juanscastano-maker/Carro_trepador/docs/guias/Guia_de_estudio_software_Carro_trepador.docx

Carro Trepador

Guía de estudio del software

Cómo está hecho el software del robot, cómo estudiarlo para entenderlo y cómo probarlo parte por parte

Nodos de ROS 2 (PC) · Firmware de la ESP32-S3 · Pruebas

Contenido

Si el índice aparece vacío, en Word: clic derecho sobre él → Actualizar campos.

# 1. Para qué sirve esta guía

El software del Carro Trepador tiene dos partes que trabajan juntas: los nodos de ROS 2, que corren en el PC y toman las decisiones, y el firmware, que corre en la ESP32-S3 y mueve el hardware. En total son unas 2 900 líneas de código repartidas en una veintena de archivos.

Esta guía explica qué hace cada archivo, propone un orden para estudiarlo (de lo más simple a lo más complejo), deja preguntas guía con sus respuestas al final para comprobar que lo entendiste, y describe cómo probar cada parte, desde las pruebas automáticas hasta el robot en la pared.

El documento de referencia es docs/arquitectura/Arquitectura_Carro_trepador_v5.docx junto con el grafo grafo nodos microproyecto.drawio.png: todo el código es ese grafo convertido en programa.

Estado actual: todo el software compila y pasa sus pruebas en el PC, incluido el sistema completo con el firmware simulado. El firmware no se ha probado todavía en la placa real: esa prueba se hace siguiendo la sección 5.

# 2. El sistema en una página

Ninguna orden llega directo a los motores: todo pasa antes por el supervisor. La única excepción es la parada de emergencia, que va de la GUI directo al firmware para que funcione aunque el supervisor falle.

ÓRDENES

GUI ─/cmd_vel─────────────→ supervisor ─/cmd_vel_safe────→ cinemática

cinemática ─/cmd_motors───→ firmware → motores N20

GUI ─/suction_gui_request─→ supervisor ─/suction_override→ succión

succión ─/cmd_suction/*───→ firmware → turbinas

GUI ─/e_stop──────────────→ firmware y supervisor (parada del operador)

supervisor ─/heartbeat────→ firmware (watchdog)

SENSORES E INFORMACIÓN

firmware ─/imu/*/data─────→ supervisor, succión y estimador

estimador ─/joint_states, /tf→ robot_state_publisher → RViz2

firmware ─/battery/state──→ supervisor y GUI

supervisor ─/gui/notifications→ GUI

firmware (núcleo 0) ══video HTTP MJPEG══→ GUI (fuera de ROS 2)

## 2.1 Los nodos y lo que hace cada uno

Nodo | Qué hace
custom_gui_node | Interfaz del operador: movimiento, petición de succión, parada y liberación, modo prueba, estado del robot, batería tipo celular, notificaciones y video.
state_machine_node (supervisor) | Decide si el robot está en SUELO, TRANSICIÓN o PARED; limita velocidad y succión; envía el heartbeat al firmware y notifica todo a la GUI. No activa la parada: eso lo decide solo el operador.
kinematics_node | Convierte la velocidad del robot (m/s y rad/s) en la potencia de los motores izquierdo y derecho (−1 a 1).
suction_control_node | Calcula la succión de cada turbina según la inclinación de su módulo; el supervisor solo puede subirla.
joint_state_estimator_node | Calcula el ángulo de la articulación central con las dos IMU y la inclinación del robot para RViz2.
robot_state_publisher | Nodo estándar de ROS 2: con el URDF y /joint_states calcula la posición de cada pieza.
micro_ros_esp32_node (firmware) | Lee IMU y batería, mueve motores y turbinas con rampas, vigila el heartbeat y la parada, y transmite el video.

## 2.2 El video

Tal como dice la arquitectura, el video no pasa por ROS 2: sale directo del núcleo 0 de la ESP32 por HTTP. Al arrancar, el firmware muestra su IP por el monitor serie y ofrece tres direcciones:

- http://<ip-robot>/: página con el video, para abrirla en cualquier navegador.
- http://<ip-robot>:81/stream: video MJPEG; es la dirección que se le pasa a la GUI con url_video.
- http://<ip-robot>/foto: una foto JPEG suelta.

Límite: el servidor de la ESP32 atiende un solo cliente de video a la vez. Si la GUI está mostrando el video, otro dispositivo no lo verá al mismo tiempo. Para verlo en varios equipos haría falta un nodo en el PC que lo lea una vez y lo reparta (sección 12.4 de la arquitectura); hoy no está en el grafo y no está implementado.

## 2.3 Reglas de seguridad del firmware

Modo | Cuándo | Qué hace
ESPERANDO | Desde que se enciende hasta el primer heartbeat | Nada se mueve: motores parados y turbinas apagadas. LED azul (o naranja si no hay agente).
NORMAL | Llega el heartbeat y no hay parada | Aplica las órdenes de motores y turbinas con rampas. LED verde.
PARADA | El operador activó la parada | Motores frenados al instante. Turbinas al máximo si el robot no está en el suelo; apagadas si está en el suelo. LED rojo.
MODO SEGURO | Más de 500 ms sin heartbeat (supervisor caído o Wi-Fi perdido) | Igual que PARADA. Vuelve solo a NORMAL cuando regresa el heartbeat. LED rojo.

# 3. Qué hay en el repositorio

## 3.1 Las carpetas

Carpeta o archivo | Qué contiene
README.md | Descripción general del proyecto, requisitos, instalación y cómo correr todo.
docs/Anteproyecto, Lista de materiales | El planteamiento del proyecto y los componentes a comprar.
docs/arquitectura/ | Documento de arquitectura y los grafos de nodos del robot real y de la simulación.
docs/electronica/ | Documento de conexiones, tabla con los 50 cables (CSV), diagrama de alimentación y de señales (draw.io y PNG).
docs/guias/ | Esta guía de estudio.
docs/simulacion/ | Documento de la simulación en Gazebo.
docs/cinematica/CAD/ | Ensamble de SolidWorks y su exportación a URDF. No se sube a GitHub por su tamaño.
docs/*.png | Pinouts de la placa ESP32-S3 y de los módulos DRV8833, INA226 y MPU6050.
ros2_ws/src/carro_trepador_interfaces | Mensaje propio Notificacion.msg.
ros2_ws/src/carro_trepador_control | Supervisor, cinemática, succión y estimador de postura, con sus pruebas.
ros2_ws/src/carro_trepador_teleop | Interfaz del operador.
ros2_ws/src/carro_trepador_bringup | Launch, parámetros, configuración de RViz2 y firmware simulado.
ros2_ws/src/carro_trepador_description | Modelo URDF con las mallas de SolidWorks y display.launch.py (RViz2 con deslizadores para mover las articulaciones).
ros2_ws/src/carro_trepador_simulation | Simulación en Gazebo (launch, mundo y sim_bridge_node). Sin probar a fondo: está en pausa mientras se trabaja con el robot real.
firmware/ | Proyecto de PlatformIO de la ESP32-S3: firmware del robot, drivers y programas de prueba.
scripts/ | adaptar_urdf_solidworks.py (convierte la exportación de SolidWorks), diagrama_alimentacion.py (dibuja el diagrama de alimentación) y generar_guia_estudio.js (genera esta guía).
matlab/, hardware/ | Reservadas para modelos matemáticos y archivos de fabricación; por ahora vacías.

## 3.2 Software del PC (ros2_ws/src)

Archivo | Líneas | Qué hace
carro_trepador_control/kinematics_node.py | 65 | Cinemática diferencial: /cmd_vel_safe → /cmd_motors.
carro_trepador_control/control/imu.py | 56 | Inclinación, cabeceo y alabeo a partir de un mensaje de IMU. Lo usan los demás nodos.
carro_trepador_control/suction_control_node.py | 125 | Succión automática por inclinación, con rampa y con el override del supervisor.
carro_trepador_control/joint_state_estimator_node.py | 123 | Ángulo de la articulación central y /tf para RViz2.
carro_trepador_control/state_machine_node.py | 323 | Supervisor: estados, límites, modo prueba, heartbeat y notificaciones.
carro_trepador_teleop/custom_gui_node.py | 509 | Interfaz PyQt5 del operador.
carro_trepador_interfaces/msg/Notificacion.msg | — | Mensaje propio de las notificaciones (INFO, AVISO, ALERTA).
carro_trepador_bringup/launch/bringup.launch.py | 78 | Arranca todo el sistema con un solo comando.
carro_trepador_bringup/config/parametros.yaml | — | Parámetros de todos los nodos en un solo lugar.
carro_trepador_bringup/rviz/robot.rviz | — | Configuración de RViz2 con el marco fijo odom.
carro_trepador_bringup/firmware_simulado.py | 182 | Herramienta de prueba: hace de ESP32 en el PC. No es parte de la arquitectura.
carro_trepador_control/test/*.py | ~250 | Pruebas unitarias y de integración (sección 4.5).

## 3.3 Firmware (firmware/)

Archivo | Líneas | Qué hace
platformio.ini | — | Configuración de PlatformIO: un entorno para el robot y uno por cada prueba de hardware.
include/pines.h | 82 | Mapa de pines y canales PWM, con el motivo de cada elección.
include/credenciales_wifi.ejemplo.h | — | Plantilla de la red Wi-Fi y la IP del PC (agente).
lib/Rampa/Rampa.h | 69 | Limitador de pendiente: arranques y frenadas graduales.
lib/Mpu6050/ | 148 | Driver de la IMU con interrupción de dato listo.
lib/Ina226/ | 143 | Driver del medidor de voltaje y corriente.
lib/Drv8833/ | 146 | Driver del puente H de los motores, con rampa.
lib/EscPwm/ | 93 | Señal de 50 Hz para los ESC de las turbinas, con rampa.
lib/FiltroOrientacion/FiltroOrientacion.h | 81 | Filtro de Mahony: orientación a partir de giroscopio y acelerómetro.
src/main.cpp | 511 | Firmware del robot (micro_ros_esp32_node): micro-ROS, sensores, actuadores y seguridad.
src/robot/video.cpp | 118 | Cámara OV2640 y servidor de video en el núcleo 0.
src/pruebas/*.cpp | — | Un programa por componente: cámara, IMU, motores, INA226 y ESC.

# 4. Ruta de estudio

La idea es avanzar de lo simple a lo complejo y, en cada paso, ejecutar el código además de leerlo. Leer sin ejecutar se olvida rápido; ver un número cambiar en la terminal se queda.

## 4.1 Etapa 0: el panorama (1 hora)

1. Abre el grafo grafo nodos microproyecto.drawio.png y el documento de arquitectura.
2. Repasa la sección 2 de esta guía y ubica cada nodo en el grafo.
3. Durante todo el estudio, cada vez que leas un nodo, búscalo en el grafo: qué recibe y qué publica.

## 4.2 Etapa 1: lo básico de ROS 2 (2 o 3 días)

Haz los tutoriales oficiales de ROS 2 Humble en docs.ros.org/en/humble/Tutorials.html. Con ellos se entiende la mayor parte del código del PC:

- Beginner: CLI tools: nodos, tópicos, servicios, parámetros, rqt y launch.
- Beginner: Client libraries: «Writing a simple publisher and subscriber (Python)», «Writing a simple service and client (Python)» y «Using parameters in a class (Python)».
- Intermediate: tf2: solo «Introducing tf2», para entender /tf y RViz2.

Conceptos que debes dominar al terminar: nodo, tópico, mensaje, servicio, parámetro, QoS, launch y TF (ver el glosario de la sección 8).

## 4.3 Etapa 2: los nodos del PC, en este orden

Archivo | Qué aprendes | Pregunta guía
1. kinematics_node.py | La estructura de un nodo: suscribirse, calcular y publicar. | P1. ¿Qué publica si pido 0.5 m/s y 2 rad/s a la vez?
2. control/imu.py | Cuaterniones y ángulos de inclinación. | P2. ¿Por qué hay dos formas de calcular cada ángulo?
3. suction_control_node.py | Timers, rampas y combinar dos fuentes con max(). | P3. ¿Por qué la succión baja más lento de lo que sube?
4. joint_state_estimator_node.py | /joint_states, /tf y robot_state_publisher. | P4. ¿Por qué el robot no avanza en RViz2 aunque el real sí?
5. state_machine_node.py | Máquina de estados, QoS, servicios e histéresis. | P5. ¿Para qué sirven los ±5° alrededor de los umbrales?
6. custom_gui_node.py | PyQt5 y cómo convive con ROS 2 (un timer que llama spin_once). | P6. ¿Por qué /cmd_vel se publica aunque sea cero?
7. bringup.launch.py y parametros.yaml | Launch con argumentos y condiciones. | P7. ¿Qué cambia con simulado:=true?

Para cada nodo, arranca el sistema simulado y obsérvalo desde afuera:

ros2 launch carro_trepador_bringup bringup.launch.py simulado:=true

rqt_graph # el grafo real: compáralo con tu drawio

ros2 node info /suction_control_node # qué publica y qué recibe

ros2 topic echo /cmd_suction/front # los valores en vivo

ros2 param set /firmware_simulado inclinacion_delantera 45.0

## 4.4 Etapa 3: el firmware, en este orden

1. include/pines.h: qué hay conectado a cada pin y por qué. Ya lo conoces por el diagrama de conexiones.
2. lib/Rampa/Rampa.h: la idea que más se repite en el firmware. Es corto y no depende de nada.
3. Los programas de src/pruebas/: cada uno usa un solo driver. Súbelos a la placa mientras los lees (sección 5.3).
4. src/main.cpp, por funciones:
  - setup(): el orden de arranque. P8. ¿Por qué los ESC se inician primero?
  - loop(): lo que se hace en cada vuelta, sin esperas.
  - atenderAgente(): la conexión con el PC y la reconexión automática (máquina de estados).
  - aplicarActuadores(): la seguridad. Es la función más importante del firmware. P9. ¿Qué pasa con las turbinas si se corta el Wi-Fi con el robot en la pared?
5. lib/FiltroOrientacion/FiltroOrientacion.h: al final. Busca primero un video de «complementary filter IMU» y luego «Mahony filter». No hace falta entender cada fórmula, sino la idea: el giroscopio es rápido pero se desvía; el acelerómetro sabe dónde está abajo y corrige ese desvío.
6. src/robot/video.cpp: cómo se arma un video MJPEG (una imagen JPEG tras otra, separadas por un límite).

Para micro-ROS, el tutorial oficial está en micro.ros.org (Tutorials → micro-ROS for Arduino / PlatformIO): ahí aparece el mismo patrón de crear entidades y vigilar al agente que usa main.cpp.

## 4.5 Etapa 4: las pruebas (aprende rompiendo)

Una prueba unitaria es un programa que llama a una función con datos conocidos y revisa que el resultado sea el esperado. Por ejemplo, test_succion.py comprueba que con 45° de inclinación la succión sea 35 %. Si mañana cambias el código y rompes algo, la prueba falla y te avisa antes de que lo descubras con el robot en la pared.

Una prueba de integración pone a funcionar varias piezas juntas. test_supervisor.py corre el supervisor de verdad con ROS 2, le envía IMU y órdenes falsas, y revisa lo que publica.

Archivo | Qué prueba
test_cinematica.py | Quieto, avanzar y retroceder, girar en el sitio y que ninguna rueda pase de 100 % sin cambiar la curva.
test_succion.py | Succión en el suelo, en la pared y en medio; que nunca baje al inclinarse más.
test_imu.py | Inclinación, cabeceo y alabeo con acelerómetro y con cuaternión; que no invente un ángulo sin datos.
test_estimador.py | Conversión de ángulos a cuaternión.
test_supervisor.py | Integración: límite de velocidad, parada y liberación, succión mínima en la pared y GUI caída.
test_flake8.py, test_pep257.py | Formato del código según las reglas de ROS 2 (líneas de máximo 99 caracteres, documentación).

### Ejercicios

1. Corre la prueba más simple y lee su salida: python3 -m pytest src/carro_trepador_control/test/test_cinematica.py -v.
2. Rompe el código a propósito: en kinematics_node.py cambia / 2.0 por / 3.0 y vuelve a correr la prueba. Mira cuál falla y por qué. Después deshaz el cambio.
3. Escribe tu propia prueba en test_succion.py: que a 35° la succión sea 17.5 %.
4. Cambia succion_pared en parametros.yaml, recompila (colcon build) y observa el cambio con el sistema simulado.

# 5. Cómo probar parte por parte

Las pruebas van de lo más seguro a lo más arriesgado. No pases al siguiente nivel hasta que el anterior funcione.

## 5.1 Nivel 1: pruebas automáticas (sin robot, segundos)

cd ~/Carro_trepador/ros2_ws

colcon build && source install/setup.bash

colcon test && colcon test-result --verbose

Resultado esperado: 38 tests, 0 errors, 0 failures, 3 skipped. Los 3 omitidos son las revisiones de licencia, que vienen desactivadas en ROS 2.

## 5.2 Nivel 2: el sistema completo sin robot (minutos)

ros2 launch carro_trepador_bringup bringup.launch.py simulado:=true

# en otra terminal, simular que el robot sube a la pared:

ros2 param set /firmware_simulado inclinacion_delantera 90.0

ros2 param set /firmware_simulado inclinacion_trasera 90.0

- La GUI muestra «Robot conectado» y la batería.
- Con W el robot avanza: la orden aparece en la GUI y en ros2 topic echo /cmd_motors.
- El estado cambia a TRANSICIÓN y luego a PARED; en RViz2 el robot se dobla y luego queda vertical.
- Espacio activa la parada; «Liberar parada» solo funciona con los controles sueltos.
- Al cerrar la GUI aparece la notificación de órdenes detenidas (en el log del supervisor).
- imu_delantera_activa:=false genera el aviso de IMU sin datos.

## 5.3 Nivel 3: el hardware, un componente a la vez

PlatformIO: el comando pio instalado en el sistema es una versión antigua (4.3.4) y falla con este proyecto. Usa el botón de PlatformIO en VS Code o la ruta completa ~/.platformio/penv/bin/pio.

Puerto USB: se programa por el USB-C marcado COM (chip CH343), que en Linux aparece como /dev/ttyACM0. Mientras el USB esté conectado, desconectar el rojo del BEC trasero: la ESP32 nunca debe recibir 5 V de dos fuentes a la vez.

# | Entorno (en firmware/) | Qué revisar

1 | prueba_imus | Las dos IMU responden (0x68 y 0x69), INT cerca de 100 Hz, az ≈ 9.8 m/s² con el robot plano.
2 | prueba_potencia | El voltaje coincide con el multímetro. Ajustar R_SHUNT y CORRIENTE_MAX al shunt instalado.
3 | prueba_motores | Con las ruedas en el aire: on y luego w; los dos lados giran hacia adelante.
4 | prueba_esc | Sin hélices o con el robot sujeto: armado con pitidos y la turbina sube suave.
5 | prueba_camara | El video se ve en el navegador.

Cada prueba se sube y se abre el monitor serie así (cambiando el nombre del entorno):

~/.platformio/penv/bin/pio run -e prueba_imus -t upload

~/.platformio/penv/bin/pio device monitor

## 5.4 Nivel 4: el firmware real conectado a ROS 2

1. Copia firmware/include/credenciales_wifi.ejemplo.h como credenciales_wifi.h y pon tu red Wi-Fi y la IP del PC (se ve con hostname -I y se escribe con comas: 192, 168, 1, 100). La red debe ser de 2.4 GHz y la misma para el PC y la ESP32; las redes de la universidad con usuario o página de inicio no sirven (usar el punto de acceso del celular).
2. Sube el firmware con las turbinas sin hélices y las ruedas en el aire:

~/.platformio/penv/bin/pio run -e esp32s3_cam -t upload

~/.platformio/penv/bin/pio device monitor

El monitor debe mostrar las IMU, el INA226 y la cámara como «ok», y luego la IP del robot y la dirección del video.

3. Carga el agente de micro-ROS (ya compilado en ~/microros_ws) y lanza todo:

source ~/microros_ws/install/setup.bash

ros2 launch carro_trepador_bringup bringup.launch.py \

url_video:=http://<ip-robot>:81/stream

Ojo con los < >: en los comandos, lo que va entre < y > se reemplaza completo, sin los signos. Por ejemplo url_video:=http://192.168.53.20:81/stream. Si se escriben los signos, la terminal los interpreta como «leer de un archivo» y responde «No existe el archivo o el directorio».

El LED de la placa debe pasar de naranja (sin agente) a verde (normal).

4. Prueba la seguridad antes de poner hélices:
- Espacio: las ruedas paran al instante y el LED se pone rojo.
- Ctrl+C en el launch: en menos de 0.5 s el robot entra en modo seguro (LED rojo, ruedas paradas).
- Con el robot inclinado a mano, las turbinas suben; en el suelo se apagan.
- Al volver a lanzar, el firmware se reconecta solo.
5. Cuando todo lo anterior funcione: hélices, primero con TURBINA_TOPE bajo en main.cpp (por ejemplo 0.4f), luego en el suelo y al final en la pared.

# 6. Respuestas a las preguntas guía

Intenta responder cada pregunta antes de leer la respuesta.

P1. ¿Qué publica kinematics_node si pido 0.5 m/s y 2 rad/s?

Sin límite, la rueda izquierda iría a (0.5 − 2·0.0829)/0.39 = 0.86 y la derecha a (0.5 + 2·0.0829)/0.39 = 1.71 (0.39 m/s es la velocidad máxima de rueda de los N20 a 5 V). Como la derecha pasa de 1, las dos se dividen por 1.71: quedan 0.50 y 1.00. Se conserva la proporción entre ruedas, así que el robot sigue la misma curva, solo que más despacio. (En el sistema completo, el supervisor ya habría limitado antes la velocidad a 0.25 m/s.)

P2. ¿Por qué hay dos formas de calcular cada ángulo?

Si el mensaje trae orientación (el firmware la calcula con el filtro de Mahony), se usa esa, porque es más estable. Si no la trae (orientation_covariance[0] = −1, la convención de ROS), se calcula solo con el acelerómetro, que vale mientras el robot no acelere fuerte.

P3. ¿Por qué la succión baja más lento de lo que sube?

Subir rápido sirve para agarrarse cuanto antes al empezar a trepar. Bajar despacio evita que el robot se suelte de golpe por un cambio brusco y reduce los picos de corriente en los ESC.

P4. ¿Por qué el robot no avanza en RViz2?

Para saber cuánto avanzó haría falta odometría (encoders en las ruedas) y para saber su rumbo un magnetómetro. El robot no tiene ninguno de los dos, así que RViz2 lo dibuja siempre en el origen. Lo que sí se ve igual que en la realidad es la inclinación y cómo se dobla la articulación.

P5. ¿Para qué sirven los ±5° alrededor de los umbrales?

Es histéresis. Si el robot está justo en 25°, la vibración haría saltar el estado entre SUELO y TRANSICIÓN muchas veces por segundo, con una notificación en cada salto. Con ±5°, para pasar a TRANSICIÓN hay que superar 30° y para volver a SUELO hay que bajar de 20°.

P6. ¿Por qué /cmd_vel se publica aunque sea cero?

Así el supervisor sabe que la GUI sigue viva. Si deja de recibir /cmd_vel por 0.5 s (la GUI se cerró o se colgó), pone la velocidad en cero y avisa. Si la GUI solo publicara al moverse, el supervisor no podría distinguir «quieto» de «GUI caída».

P7. ¿Qué cambia con simulado:=true?

El launch no arranca el agente de micro-ROS (no hay ESP32) y en su lugar arranca firmware_simulado, que publica y recibe los mismos tópicos que el firmware real. Los demás nodos no se enteran de la diferencia.

P8. ¿Por qué los ESC se inician primero en setup()?

Un ESC solo se arma si al recibir batería ve la señal de 0 % (pulso de 1000 µs). Si la ESP32 tardara en empezar a mandar la señal, el ESC podría quedar sin armar o, peor, leer un pulso cualquiera. Por eso es lo primero que se configura.

P9. ¿Qué pasa con las turbinas si se corta el Wi-Fi con el robot en la pared?

Deja de llegar el heartbeat; a los 500 ms el firmware entra en MODO SEGURO: frena los motores y, como las IMU dicen que no está en el suelo, sube las turbinas al máximo para que quede pegado. Cuando vuelve la conexión y el heartbeat, regresa solo a NORMAL.

# 7. Comandos útiles

Comando | Para qué sirve
colcon build && source install/setup.bash | Compilar el workspace y cargarlo en la terminal.
ros2 launch carro_trepador_bringup bringup.launch.py simulado:=true | Todo el sistema sin robot.
ros2 node list | Qué nodos están corriendo.
ros2 node info /<nodo> | Qué publica, recibe y ofrece un nodo.
ros2 topic list / ros2 topic echo <tópico> | Ver los tópicos y sus mensajes en vivo.
ros2 topic hz <tópico> | Frecuencia real de un tópico (las IMU deben estar cerca de 50 a 100 Hz).
ros2 param list / ros2 param set /<nodo> <param> <valor> | Ver y cambiar parámetros en vivo.
ros2 service call /set_test_mode std_srvs/srv/SetBool "{data: true}" | Activar el modo prueba sin la GUI.
rqt_graph | Dibujo del grafo real de nodos y tópicos.
colcon test && colcon test-result --verbose | Correr todas las pruebas.
python3 -m pytest <archivo> -v | Correr un archivo de pruebas con detalle.
~/.platformio/penv/bin/pio run -e <entorno> -t upload | Compilar y subir el firmware o una prueba.
~/.platformio/penv/bin/pio device monitor | Ver el monitor serie de la ESP32.

# 8. Glosario

Término | Significado
Nodo | Un programa de ROS 2 con una tarea. Se comunica con los otros por tópicos y servicios.
Tópico | Canal con nombre (por ejemplo /cmd_vel) por el que un nodo publica mensajes y otros los reciben.
Mensaje | La estructura de datos que viaja por un tópico (por ejemplo sensor_msgs/Imu).
Servicio | Pregunta y respuesta entre dos nodos. Se usa en /set_test_mode: la GUI pide y el supervisor acepta o rechaza.
Parámetro | Un valor de configuración de un nodo que se puede cambiar sin tocar el código (parametros.yaml o ros2 param set).
QoS | Reglas de entrega de un tópico. Reliable: se reenvía hasta que llega (parada de emergencia). Best effort: si se pierde, llega el siguiente (IMU y batería). Transient local: el que llega tarde recibe los últimos mensajes (notificaciones).
Launch | Archivo que arranca varios nodos a la vez con sus parámetros.
TF | El árbol de transformaciones: dónde está y cómo está girada cada pieza respecto a las demás.
URDF | Descripción del robot (piezas, articulaciones y mallas) que usan RViz2 y Gazebo.
micro-ROS y agente | micro-ROS es ROS 2 para microcontroladores. El agente es el programa del PC que conecta la ESP32 (por Wi-Fi/UDP) con el resto de ROS 2.
Heartbeat y watchdog | El supervisor envía un «sigo vivo» 10 veces por segundo; el watchdog del firmware entra en modo seguro si deja de llegar por 500 ms.
Histéresis | Usar umbrales distintos para entrar y salir de un estado, para que no salte de un lado a otro.
Rampa | Cambiar un valor de forma gradual hasta su objetivo, a una velocidad máxima.
BEC | Regulador de 5 V que traen los ESC. En este robot el del ESC delantero alimenta el DRV8833 y el del trasero la ESP32. Son lineales: se calientan.
Cuaternión | Cuatro números (w, x, y, z) que representan una orientación sin los problemas de los ángulos a 90°.
Filtro de Mahony | Combina giroscopio y acelerómetro para estimar la orientación de cada IMU.
MJPEG | Video hecho de imágenes JPEG enviadas una tras otra por HTTP.
PWM y LEDC | PWM es una señal que se prende y apaga muy rápido para regular potencia. LEDC es el periférico de la ESP32 que la genera.

# 9. Consejos para estudiar

- Estudia por sesiones cortas, un archivo a la vez, y escribe con tus palabras qué hace antes de pasar al siguiente.
- Antes de cambiar algo, corre las pruebas; después de cambiarlo, córrelas otra vez.
- Si no entiendes una línea, pregunta señalando el archivo y el número de línea (por ejemplo, state_machine_node.py, línea 257) para recibir la explicación con su contexto.
- Cuando pruebes con hardware, una sola cosa nueva a la vez, y siempre la seguridad primero: hélices fuera, ruedas en el aire y la parada a mano.

Carro Trepador · Guía de estudio del software
