juanscastano-maker/Carro_trepador/docs/simulacion/Simulacion_Carro_trepador_v3.docx

# Robot Carro Trepador — Simulación en Gazebo (v3)

Este documento describe cómo se simula el robot en Gazebo, qué está implementado y verificado, qué se encontró en las primeras pruebas y qué falta construir. El objetivo de la simulación es diseñar y ajustar los algoritmos de control por iteraciones (arranques suaves, giros y transición entre suelo y pared) antes de probarlos en el robot real.

Estado: la simulación básica funciona (el robot carga, sus IMUs publican y se puede mover con un comando de prueba). Todavía no existen el modelo de succión, el puente de simulación ni los mundos con pared, así que aún no se puede simular la subida a una pared (sección 6).

## 1. Para qué sirve la simulación

La simulación permite probar los algoritmos de control sin arriesgar el robot: se repite una maniobra, se miden los resultados, se ajusta el algoritmo y se vuelve a probar. Solo cuando un algoritmo funciona bien en simulación se prueba en el robot real.

Objetivo de control | Qué se busca mejorar en cada iteración
Arranque y frenado suaves | Que el robot acelere y frene sin tirones que puedan despegarlo de la pared.
Giros | Que gire el ángulo pedido sin desplazarse de más ni patinar.
Transición suelo-pared y pared-suelo | Que pase de una superficie a otra sin perder adherencia, con la succión adecuada en cada módulo.

Límite importante: Gazebo no simula la aerodinámica de las turbinas. La adhesión se representa con un modelo simplificado (sección 6.2), así que los valores ajustados en simulación son un punto de partida y deben confirmarse en el robot real.

## 2. Herramientas

Herramienta | Uso
Gazebo Fortress (6.18) | Simulador de física. Es la versión recomendada para ROS 2 Humble.
ros_gz_sim | Lanza Gazebo desde ROS 2 y crea el robot a partir del URDF.
ros_gz_bridge | Conecta los tópicos de Gazebo con los de ROS 2 (IMUs, articulaciones, reloj).
RViz2 | Visualiza el modelo y los datos. Con el robot real funciona como gemelo digital.

Instalación (una sola vez):

sudo apt install ros-humble-ros-gz

## 3. Modelo del robot en simulación

El modelo sale del ensamble de SolidWorks exportado con sw_urdf_exporter y está en carro_trepador_description/urdf/carro_trepador.urdf. Las mallas visuales son las originales de SolidWorks, sin modificar. La exportación es un paquete de ROS 1, así que se adaptó a ROS 2 con estos cambios:

Cambio | Motivo
Rutas de mallas a package://carro_trepador_description | La exportación apuntaba a un paquete llamado Ensamblaje1_juan, que no existe en el workspace.
Ruedas traseras de fixed a continuous | Giran libres aunque no tengan motor. Con fixed se arrastrarían como si estuvieran frenadas.
Eje de las 6 ruedas invertido | Para que una velocidad positiva haga avanzar al robot.
Link raíz base_link sin inercia | Convención de ROS y requisito de robot_state_publisher (KDL no admite inercia en la raíz).
Marcos imu_front_link e imu_rear_link | Posición del chip MPU6050 tomada del ensamble. Placas planas, chip arriba, lado largo hacia adelante.
Colisiones simples | Cajas para los chasis y cilindros para las ruedas, en vez de mallas de 600 mil triángulos.
Fricción anisotrópica en las llantas | Sin esto el robot no gira en Gazebo (sección 5).
Bloques de Gazebo | IMUs simuladas, publicación de articulaciones y tracción de prueba.

Colisiones

Pieza | Forma | Medidas
chasis_trasero_link | Caja | 163 × 180 × 37 mm, levantada 4 mm del suelo
chasis_delantero_link | Caja | 161 × 182 × 63 mm, levantada 4 mm del suelo
6 ruedas | Cilindro | Radio 15 mm, ancho 22 mm
Hélices | Sin colisión | Solo visuales, están dentro de las turbinas

Pendiente de verificar: las masas e inercias las calculó SolidWorks (unos 0.41 kg en total) y no se han comparado con el peso real. El chasis es de PLA impreso, que con relleno parcial pesa menos que una pieza maciza. Hay que pesar cada módulo o asignar los materiales y masas reales en SolidWorks y reexportar. También falta confirmar hacia dónde apunta la flecha X impresa en las placas GY-521.

## 4. Lo que está implementado y verificado

Hoy la simulación vive en carro_trepador_description: launch/gazebo.launch.py y worlds/vacio.sdf (un suelo plano). Se pasará al paquete carro_trepador_simulation (sección 6).

Tópicos de la simulación actual

Tópico | Tipo | Sentido | Origen | Uso
/imu/front/data /imu/rear/data | sensor_msgs/msg/Imu | Gazebo → ROS | IMUs simuladas, 100 Hz | Mismos tópicos que el firmware real.
/joint_states | sensor_msgs/msg/JointState | Gazebo → ROS | Gazebo | Ángulo de las 9 articulaciones, incluida la central.
/clock | rosgraph_msgs/msg/Clock | Gazebo → ROS | Gazebo | Tiempo simulado (use_sim_time).
/sim/cmd_vel | geometry_msgs/msg/Twist | ROS → Gazebo | Usuario | Solo para pruebas manuales: mueve las 4 ruedas con motor.
/sim/odom | nav_msgs/msg/Odometry | Gazebo → ROS | Gazebo | Odometría calculada del giro de las ruedas.

Resultados de las pruebas (4 de octubre de 2026)

Las distancias y ángulos se midieron con la pose real del robot dentro de Gazebo, no con la odometría, porque la odometría se calcula del giro de las ruedas y da un resultado perfecto aunque patinen.

Prueba | Resultado | Estado
Carga del modelo | Se crea el robot y se encuentran todas las mallas | Correcto
Reposo | Quieto sobre el suelo; IMUs miden 9.80 m/s² hacia arriba y ~0 en x e y | Correcto
IMUs | Publican con frame_id imu_front_link e imu_rear_link | Correcto
Articulaciones | /joint_states trae las 9 articulaciones | Correcto
Avance 0.1 m/s durante 3 s | Avanzó 0.302 m en línea recta (ideal 0.30 m) | Correcto
Giro ±1 rad/s durante 1.5 s | Giró +85.0° y −85.1° (ideal ±86°), desplazándose unos 10 cm | Correcto con fricción anisotrópica

## 5. Hallazgo: el giro depende de la fricción lateral

Con la misma fricción en todas las direcciones (μ = 1), el robot avanzaba bien pero no giraba: al pedirle un giro se quedaba en 0°. Las 6 ruedas en fila (unos 30 cm de largo), con las traseras sin motor, frenan de lado más de lo que las 4 ruedas motrices empujan para girar. Se descartó que fuera la forma de la colisión (con esferas pasó lo mismo) o un problema de contacto (las 6 ruedas están a la misma altura).

Solución en la simulación: las llantas tienen fricción baja de lado (mu1, en la dirección del eje, fdir1) y fricción normal al rodar (mu2 = 1.0). Se probaron varios valores:

Fricción lateral (mu1) | Giro con +86° pedido | Conclusión
1.0 (igual en todas las direcciones) | 0° | No gira
0.5 | +5° | Casi no gira
0.3 | +85° | Gira bien. Es el valor elegido
0.1 | +86° | Gira bien, pero es demasiado optimista

Advertencia para el robot real: las llantas reales agarran de lado casi igual que al rodar, así que el robot real podría tener el mismo problema para girar en el sitio, sobre todo en superficies con buen agarre. Debe probarse apenas el chasis esté armado. Si no gira, las opciones son motorizar las ruedas traseras, usar llantas con menos agarre lateral o acortar la distancia entre ejes.

## 6. Lo que falta construir

6.1 Puente de simulación (sim_bridge_node)

Para que lo ajustado en simulación sirva en el robot real, Gazebo debe reemplazar solo al firmware. Los nodos de control (supervisor, cinemática, succión) y la GUI deben ser exactamente los mismos en los dos casos. sim_bridge_node recibe los mismos tópicos que la ESP32 y los traduce a Gazebo:

Tópico | Tipo | Sentido | Qué hace el puente | Equivale en el robot real a
/cmd_motors | std_msgs/msg/Float32MultiArray | ROS → puente | Fija la velocidad de las 4 ruedas con motor | PWM a los N20
/cmd_suction/front /cmd_suction/rear | std_msgs/msg/Float32 | ROS → puente | Ajusta la fuerza de adhesión de cada módulo (6.2) | PWM a los ESC
/heartbeat | std_msgs/msg/UInt32 | ROS → puente | Watchdog de 500 ms, igual que el firmware | Watchdog del firmware
/e_stop | std_msgs/msg/Bool | ROS → puente | Modo seguro, igual que el firmware | Modo seguro del firmware
/battery/state | sensor_msgs/msg/BatteryState | puente → ROS | Batería simulada (voltaje configurable) | Medición de la batería

Las IMUs no pasan por el puente: Gazebo las publica directamente en /imu/front/data y /imu/rear/data. El grafo de la simulación está en la arquitectura v5 (docs/arquitectura). En ese grafo todavía falta dibujar la conexión del puente hacia gazebo (observación 12.4 de la v5). Mientras tanto, el puente mueve las ruedas a través del tópico /sim/cmd_vel de Gazebo.

6.2 Modelo de succión

Propuesta: aplicar a cada chasis una fuerza perpendicular a la superficie, hacia ella, proporcional a la potencia pedida a su turbina, y solo cuando el chasis está cerca de la superficie (la falda casi toca el suelo o la pared). Fuerza = k × potencia (%), con k distinto para cada módulo si hace falta.

La constante k debe salir de una medición en el robot real: con el módulo apoyado sobre una superficie, medir con una balanza o un dinamómetro la fuerza necesaria para despegarlo a distintas potencias de turbina. Mientras no exista esa medición, k se estima y los resultados son solo orientativos.

Implementación: a definir. La opción más probable es un plugin propio de Gazebo (C++) dentro de carro_trepador_simulation, que lea la potencia publicada por el puente y aplique la fuerza en cada paso de simulación.

6.3 Mundos de prueba

Mundo | Contenido | Para probar
vacio (existe) | Suelo plano | Avance, giro, arranque y frenado
rampas | Rampas de 15°, 30°, 45° y 60° | Adhesión y tracción con pendiente creciente
transicion | Suelo con una pared vertical a 90° | Paso de suelo a pared y de pared a suelo
pared | Pared vertical alta | Avance y giro sobre la pared

6.4 Paquete carro_trepador_simulation

Se creará un paquete nuevo para todo lo de simulación: launch de Gazebo, mundos, configuración del puente ros_gz, sim_bridge_node y el plugin de succión. Así carro_trepador_description queda solo con el modelo del robot, que sirve tanto para el real como para el simulado.

6.5 Estimador para el gemelo digital

joint_state_estimator_node (carro_trepador_control) calcula el ángulo de la articulación central y la inclinación del robot a partir de las dos IMUs, y publica /joint_states y /tf para RViz. En simulación funciona igual que con el robot real: es el que publica /joint_states. Para comprobar que estima bien, el /joint_states propio de Gazebo (el valor real de la simulación) se renombra a /sim/joint_states_real y se compara con el estimado.

## 7. Método para mejorar el control por iteraciones

1) Elegir un escenario (mundo y maniobra). 2) Correr la maniobra y grabar todos los tópicos con ros2 bag. 3) Calcular las métricas. 4) Cambiar un solo parámetro o parte del algoritmo. 5) Repetir y comparar. Cada iteración se registra en docs/control con la fecha, qué se cambió y las métricas, para poder volver atrás si un cambio empeora el resultado.

Objetivo | Métricas | Escenario
Arranque y frenado suaves | Aceleración máxima, tiempo para llegar a la velocidad pedida | vacio y pared
Giros | Error del ángulo final, desplazamiento durante el giro | vacio y pared
Transición suelo-pared | Éxito o caída, tiempo de transición, ángulo máximo de la articulación, succión mínima durante el paso | transicion

## 8. Cómo ejecutar la simulación

Compilar el workspace:

cd ~/Carro_trepador/ros2_ws && source /opt/ros/humble/setup.bash && colcon build --symlink-install && source install/setup.bash

Abrir Gazebo con el robot:

ros2 launch carro_trepador_description gazebo.launch.py

Gazebo con RViz2 al mismo tiempo:

ros2 launch carro_trepador_description gazebo.launch.py rviz:=true

Gazebo sin ventana (pruebas automáticas):

ros2 launch carro_trepador_description gazebo.launch.py gui:=false

Mover el robot (prueba manual, en otra terminal):

ros2 topic pub -r 10 /sim/cmd_vel geometry_msgs/msg/Twist "{linear: {x: 0.1}}"

Ver las IMUs simuladas:

ros2 topic echo /imu/rear/data

## 9. Pendientes

1) Crear el paquete carro_trepador_simulation y mover ahí el launch y el mundo de Gazebo.

2) Implementar sim_bridge_node (6.1) y el modelo de succión (6.2).

3) Crear los mundos rampas, transicion y pared (6.3).

4) Implementar joint_state_estimator_node (6.5).

5) Medir en el robot real la fuerza de adhesión contra la potencia de turbina para calibrar k.

6) Verificar las masas con una balanza y la flecha X de las placas GY-521.

7) Probar en el robot real si gira en el sitio (sección 5).

8) Renombrar en el launch de Gazebo su /joint_states a /sim/joint_states_real, para que no choque con el del estimador.
