juanscastano-maker/Carro_trepador/docs/Lista de materiales a comprar.pdf

# Lista de materiales

## Pedidos en línea:

### 4 motores N20 de 6V 300 RPM

Precio individual: $ 5.890,00

Precio envío: $ 8.028,88

Total: $ 31.588,88

https://es.aliexpress.com/item/33022320164.html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 (https://es.aliexpress.com/item/33022320164.html)

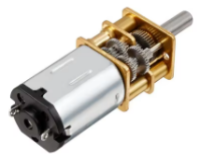
[picture p10: figure]

### 2 motores BLDC IFlight XING2 1404 a 4600KV

Precio individual: $ 38.948,00

Precio envío: $ 13.982,78

Total: $ 91.878,78

https://es.aliexpress.com/item/1005009293973448.html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 (https://es.aliexpress.com/item/1005009293973448.html)

### 1 paquete de 4 Hélices Gemfan 3016-3 de 1.5mm tipo Toothpick de 3 pulgadas

Precio individual: $ 9.269,00

Precio envío: $ 0

Total: $ 9.269,00

https://es.aliexpress.com/item/1005011555901023.html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 (https://es.aliexpress.com/item/1005011555901023.html)

### 2 ESC Hobbywing Skywalker v2 de 30A con BEC/UBEC

Precio individual: $ 42.555,00

Precio envío: $ 27.495,31

Total: $ 112.605,31

https://es.aliexpress.com/item/1005009121133056.html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 (https://es.aliexpress.com/item/1005009121133056.html)

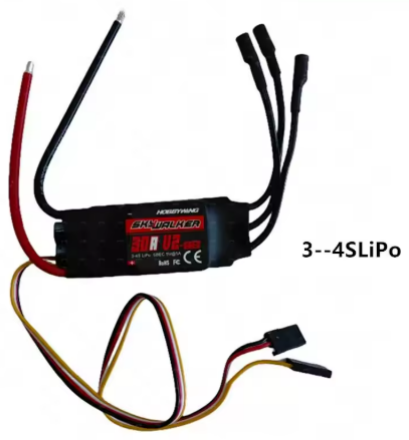
[picture p11: figure]

### 1 batería Lipo HV GAONENG GNB 1100mAh 4S 15.2V con Conector XT30

Precio individual: $ 61.971,00

Precio envío: $ 46.194,33

Total: $ 108.165,33

https://es.aliexpress.com/item/1005012599865662.html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 (https://es.aliexpress.com/item/1005012599865662.html)

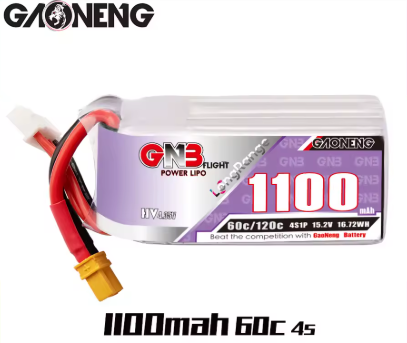
[picture p12: figure]

### 1 Módulo de Desarrollo ESP ESP32-S3 CAM N16R8 Integrado, Cámara Dual TYPE-C OV2640

Precio individual: $ 39.879,00

Precio envío: $ 10.700,3

Total: $ 50.579,30

https://es.aliexpress.com/item/1005012751443516.html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 (https://es.aliexpress.com/item/1005012751443516.html)

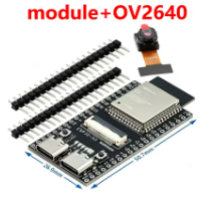
[picture p13: figure]

Placa de Módulo de Control de Motor DRV8833

Precio individual: $ 5.118,00

Precio envío: $ 10.022,6

Total: $ 15.140,60

https://es.aliexpress.com/item/1005012556500959.html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 (https://es.aliexpress.com/item/1005012556500959.html)

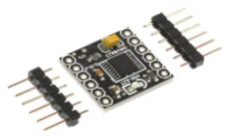
[picture p14: figure]

### 2 pares de llantas Minisumo 31x23mm con Tornillos

Precio individual: $ 39.000,0

Precio envío: $ 21.000,0

Total: $ 99.000,0

https://ja-bots.com/producto/llantas-minisumo-31x23mm-par-amarillo-con-tornillos/

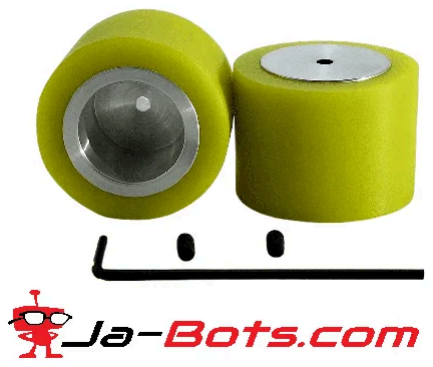
[picture p15: figure]

### 1 INA226 Módulo Sensor de Monitoreo de Corriente y Voltaje

Precio individual: $ 19.700,0

Precio envío: $ 0

Total: $ 19.700,0

https://www.mercadolibre.com.co/ina226-iic-i2c-sensor-de-corpot-bidireccional-para-arduino/p/MCO2046304522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 (https://www.mercadolibre.com.co/ina226-iic-i2c-sensor-de-corpot-bidireccional-para-arduino/p/MCO2046304522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)

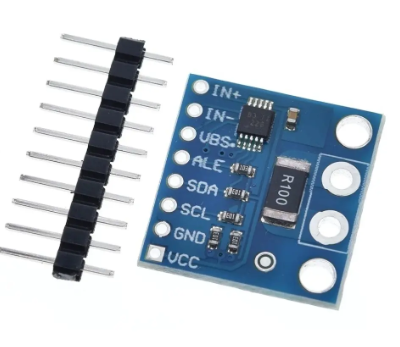
[picture p16: figure]

## Total pedidos en línea: $ 537.927,2

## Compras locales:

### 2 Módulos MPU-6050

Precio individual: $ 19.800,00

Total: $ 39.600,00

ELECTRÓNICA SAN NICOLÁS

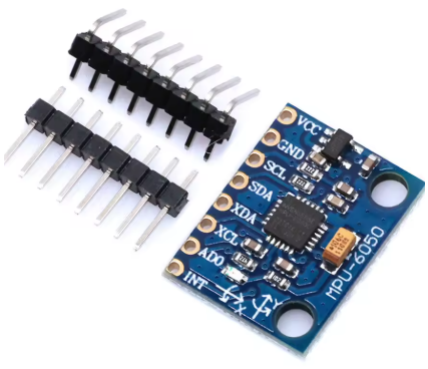
[picture p17: figure]

## Total compras locales: $ 39.600,00

## Total proyecto: $ 577.527,2

* Lista de precios del 28/09/2026
* Lista de materiales en fase preliminar (pendiente de agregar precios y materiales de construcción de chasis)
