juanscastano-maker/Carro_trepador/docs/cinematica/CAD/archivos stl binario para impresion 3d/varilla para eje carrito ensamble.STL

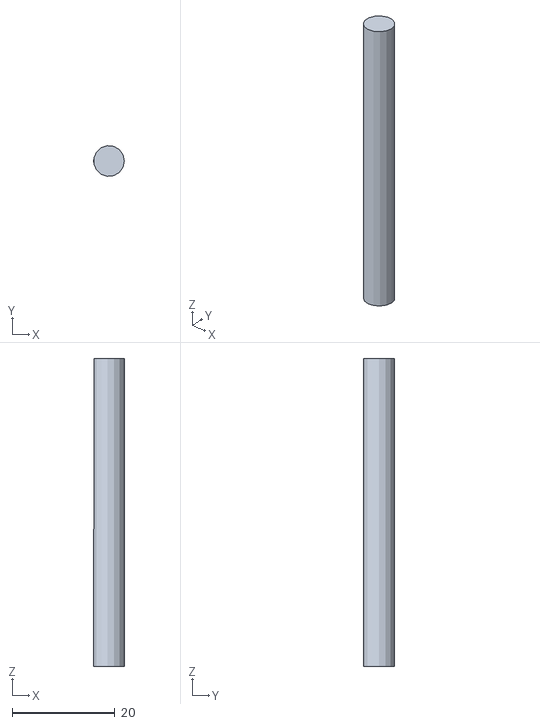
[picture p18: CAD file, 2026-10-28]
docs/cinematica/CAD/archivos stl binario para impresion 3d/varilla para eje carrito ensamble.STL
6.00 x 5.97 x 60.0
