juanscastano-maker/Carro_trepador/docs/cinematica/CAD/archivos stl binario para impresion 3d/Pieza32^Ensamblaje1_juan.STL

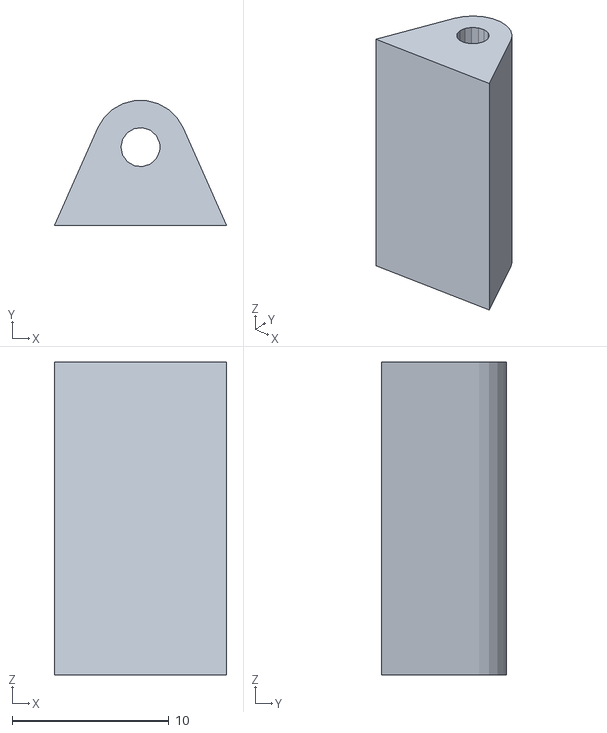
[picture p19: CAD file, 2026-10-28]
docs/cinematica/CAD/archivos stl binario para impresion 3d/Pieza32^Ensamblaje1_juan.STL
11.0 x 7.98 x 20.0
