juanscastano-maker/Carro_trepador/docs/cinematica/CAD/archivos stl binario para impresion 3d/falda.STL

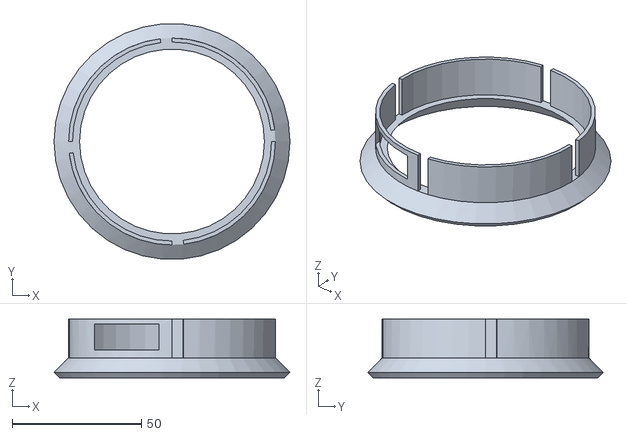
[picture p20: CAD file, 2026-10-28]
docs/cinematica/CAD/archivos stl binario para impresion 3d/falda.STL
91.3 x 91.0 x 22.8
