juanscastano-maker/Carro_trepador/docs/cinematica/CAD/SOPORTE_MT.SLDPRT

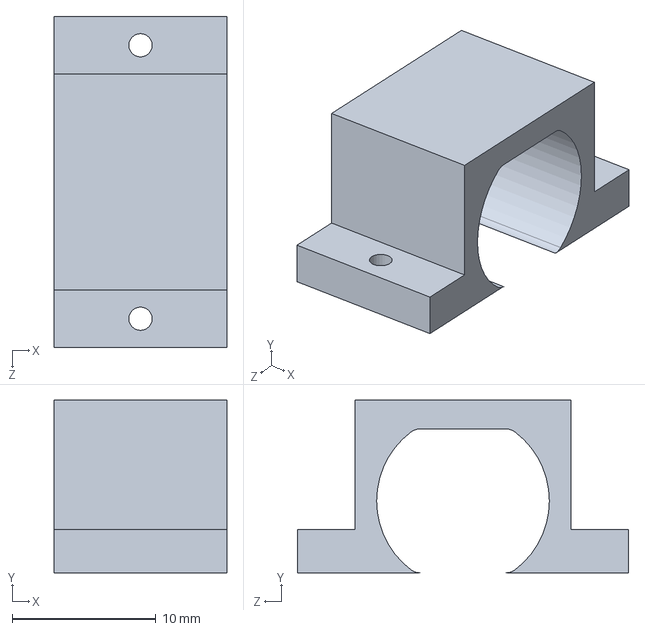
[picture p21: CAD file, 2026-10-28]
docs/cinematica/CAD/SOPORTE_MT.SLDPRT
12.0 x 12.0 x 23.0 mm
