juanscastano-maker/Carro_trepador/docs/cinematica/CAD/URDF/Ensamblaje1_juan/meshes/chasis_delantero_link.STL

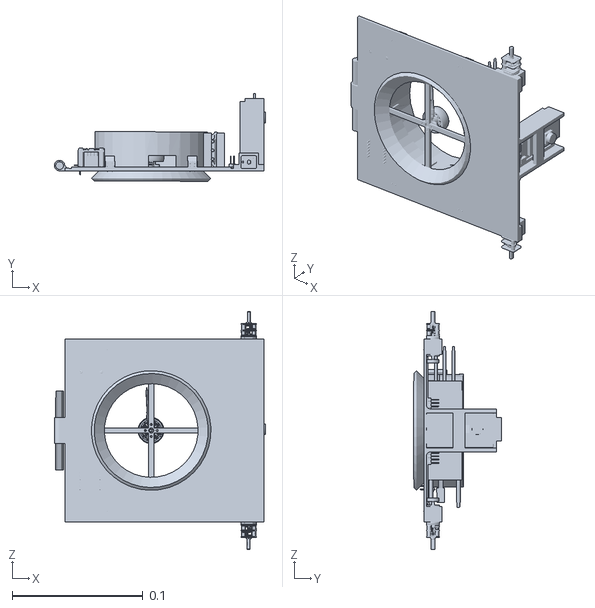
[picture p22: CAD file, 2026-10-28]
docs/cinematica/CAD/URDF/Ensamblaje1_juan/meshes/chasis_delantero_link.STL
0.161 x 0.0669 x 0.182
