juanscastano-maker/Carro_trepador/ros2_ws/src/carro_trepador_description/meshes/rueda_trasera_izquierda_link.STL

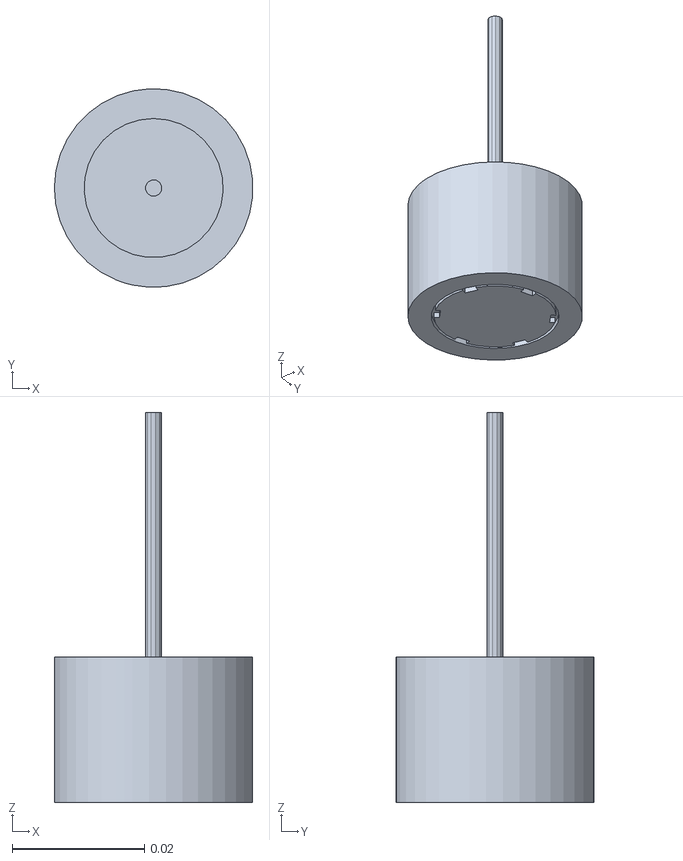
[picture p23: CAD file, 2026-10-28]
ros2_ws/src/carro_trepador_description/meshes/rueda_trasera_izquierda_link.STL
0.03 x 0.03 x 0.0589
