juanscastano-maker/Carro_trepador/docs/cinematica/CAD/archivos stl binario para impresion 3d/CHASIS1_modificado.STL

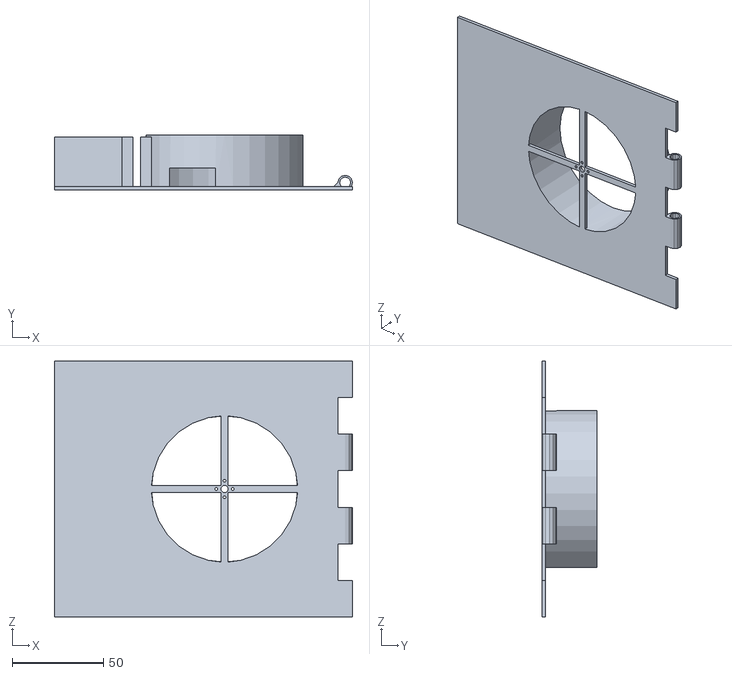
[picture p24: CAD file, 2026-10-28]
docs/cinematica/CAD/archivos stl binario para impresion 3d/CHASIS1_modificado.STL
163.0 x 30.0 x 140.0
