juanscastano-maker/Carro_trepador/ros2_ws/src/carro_trepador_description/meshes/rueda_delantera_izquierda_Link.STL

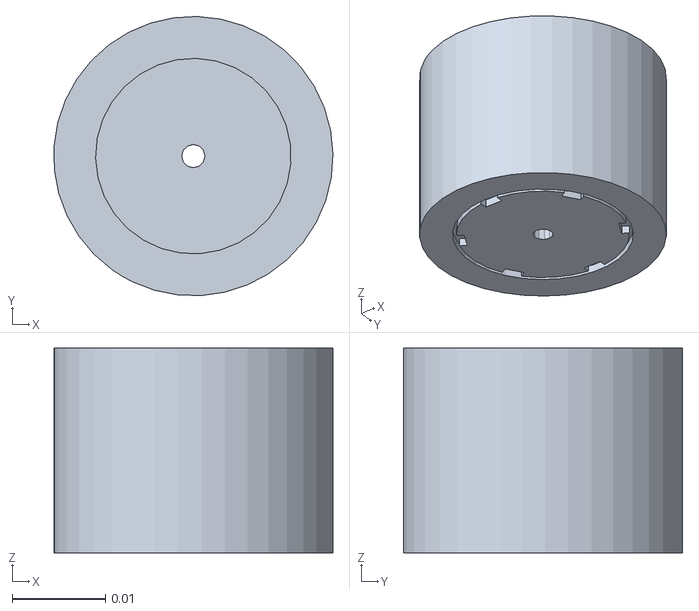
[picture p25: CAD file, 2026-10-28]
ros2_ws/src/carro_trepador_description/meshes/rueda_delantera_izquierda_Link.STL
0.03 x 0.03 x 0.022
