juanscastano-maker/Carro_trepador/docs/cinematica/CAD/URDF/Ensamblaje1_juan/meshes/chasis_trasero_link.STL

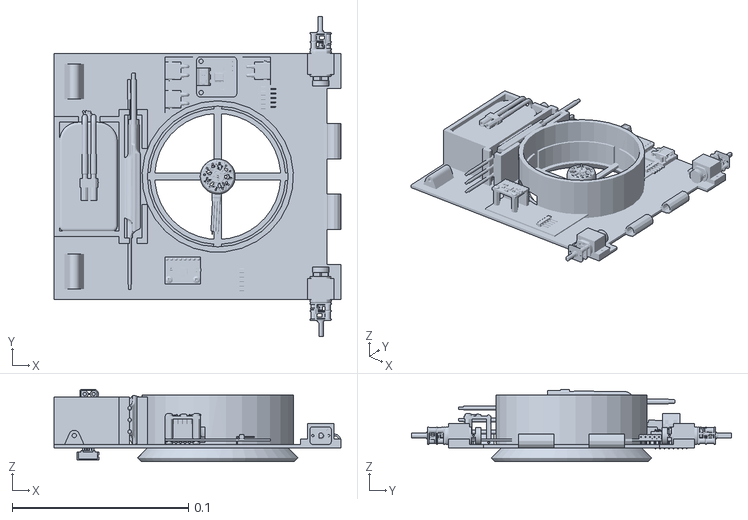
[picture p26: CAD file, 2026-10-28]
docs/cinematica/CAD/URDF/Ensamblaje1_juan/meshes/chasis_trasero_link.STL
0.163 x 0.182 x 0.041
