juanscastano-maker/Carro_trepador/ros2_ws/src/carro_trepador_description/meshes/helice_trasera_link.STL

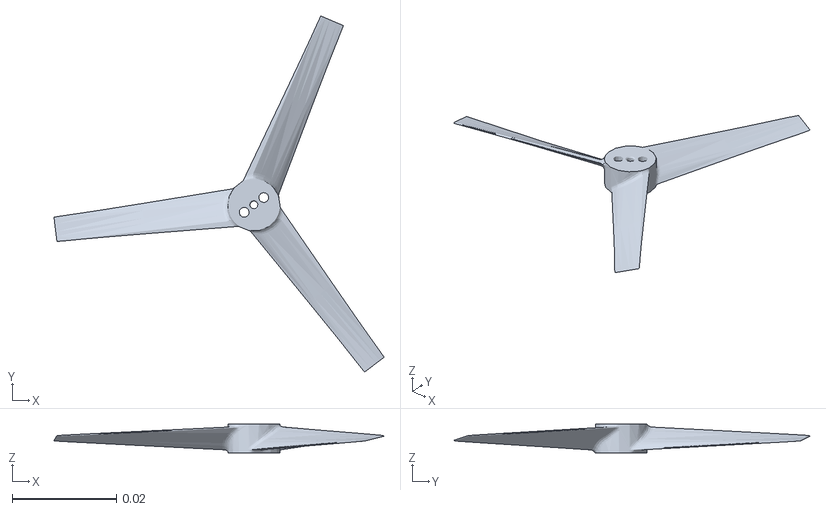
[picture p27: CAD file, 2026-10-28]
ros2_ws/src/carro_trepador_description/meshes/helice_trasera_link.STL
0.0633 x 0.0682 x 0.0055
