juanscastano-maker/Carro_trepador/docs/cinematica/CAD/XING2 1404 v5.step

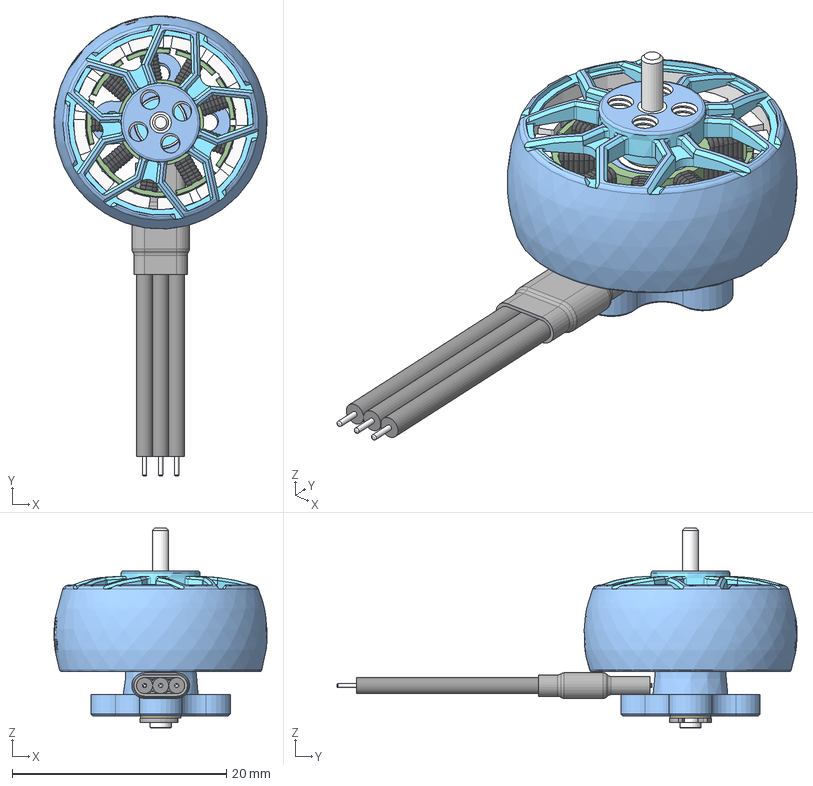
[picture p28: CAD file, 2026-10-28]
docs/cinematica/CAD/XING2 1404 v5.step
19.9 x 42.9 x 18.6 mm
Motor Bell
Steel Insert
Magnets
Shaft
2x3mm Oring
Brass Washer x 2
98543A070_Side-Mount External Retaining Rings
7487N14_Precision Stainless Steel Ball Bearing x 2
Motor Mount
Stator
Heat Shrink
