juanscastano-maker/Carro_trepador/ros2_ws/src/carro_trepador_description/meshes/helice_delantera_link.STL

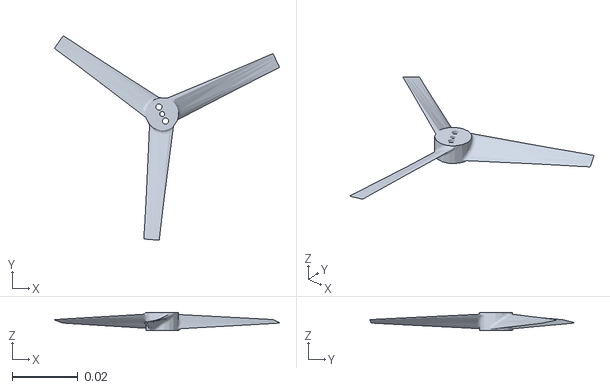
[picture p29: CAD file, 2026-10-28]
ros2_ws/src/carro_trepador_description/meshes/helice_delantera_link.STL
0.0685 x 0.0622 x 0.0055
