juanscastano-maker/Carro_trepador/docs/cinematica/CAD/archivos stl binario para impresion 3d/CHASIS2_modificado.STL

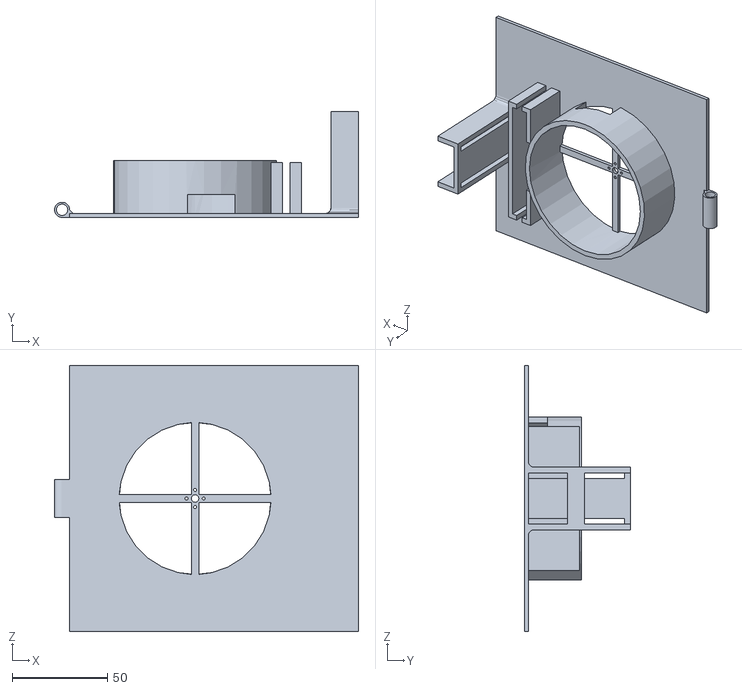
[picture p30: CAD file, 2026-10-28]
docs/cinematica/CAD/archivos stl binario para impresion 3d/CHASIS2_modificado.STL
160.0 x 55.7 x 140.0
