juanscastano-maker/Carro_trepador/docs/cinematica/CAD/esp32-s3_cam.SLDPRT

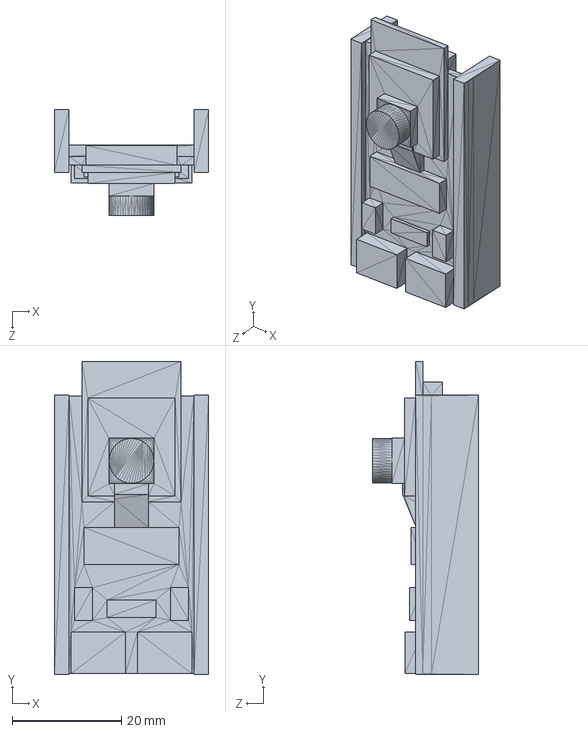
[picture p31: CAD file, 2026-10-28]
docs/cinematica/CAD/esp32-s3_cam.SLDPRT
28.3 x 57.3 x 19.4 mm
