juanscastano-maker/Carro_trepador/docs/cinematica/CAD/CHASIS2.SLDPRT

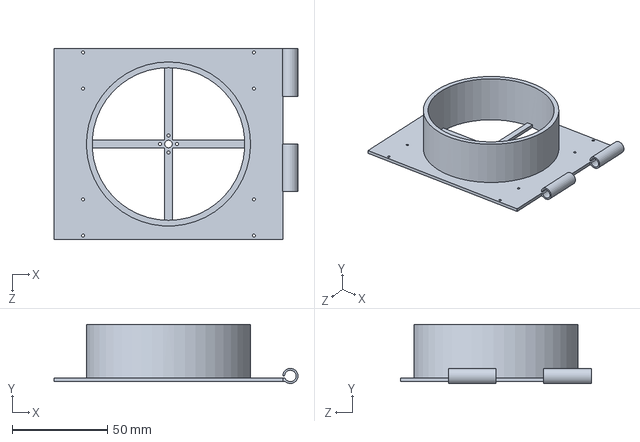
[picture p32: CAD file, 2026-10-28]
docs/cinematica/CAD/CHASIS2.SLDPRT
127.9 x 31.0 x 100.0 mm
