juanscastano-maker/Carro_trepador/docs/cinematica/CAD/Hobbywing Skywalker 80A-UBEC 2S-6S v1.step

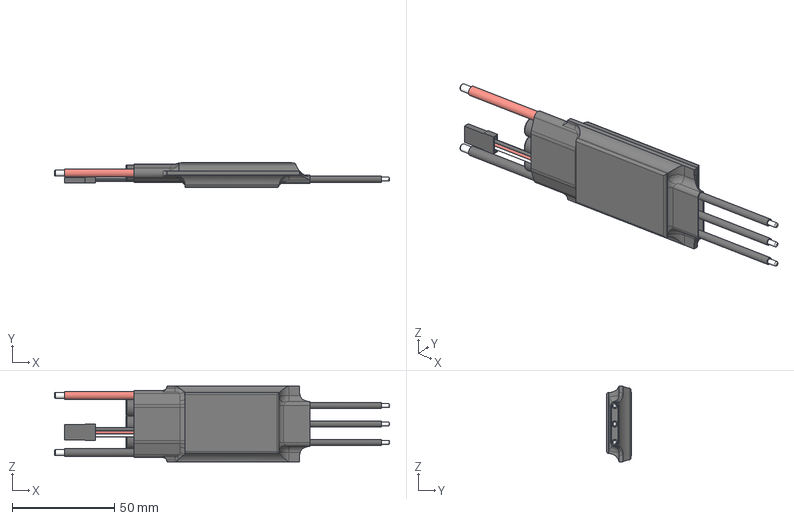
[picture p33: CAD file, 2026-10-28]
docs/cinematica/CAD/Hobbywing Skywalker 80A-UBEC 2S-6S v1.step
164.0 x 12.1 x 37.0 mm
