juanscastano-maker/Carro_trepador/docs/cinematica/CAD/Hobbywing Skywalker 80A-UBEC 2S-6S v1 (Redimensionado para que parezca V2 30A).SLDPRT

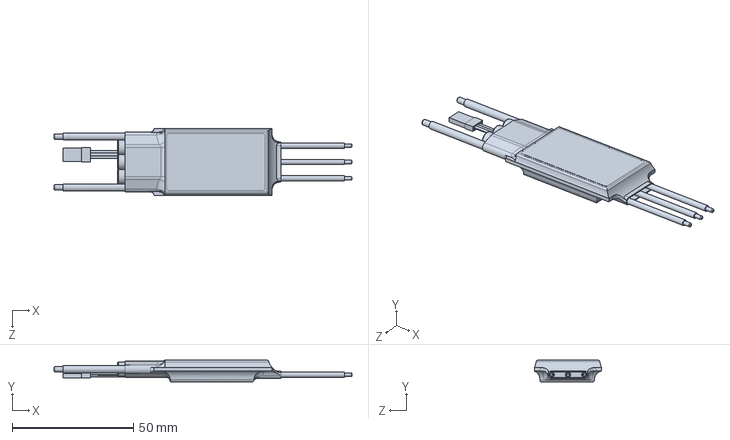
[picture p34: CAD file, 2026-10-28]
docs/cinematica/CAD/Hobbywing Skywalker 80A-UBEC 2S-6S v1 (Redimensionado para que parezca V2 30A).SLDPRT
123.0 x 9.07 x 27.7 mm
