juanscastano-maker/Carro_trepador/docs/cinematica/CAD/llanta.SLDPRT

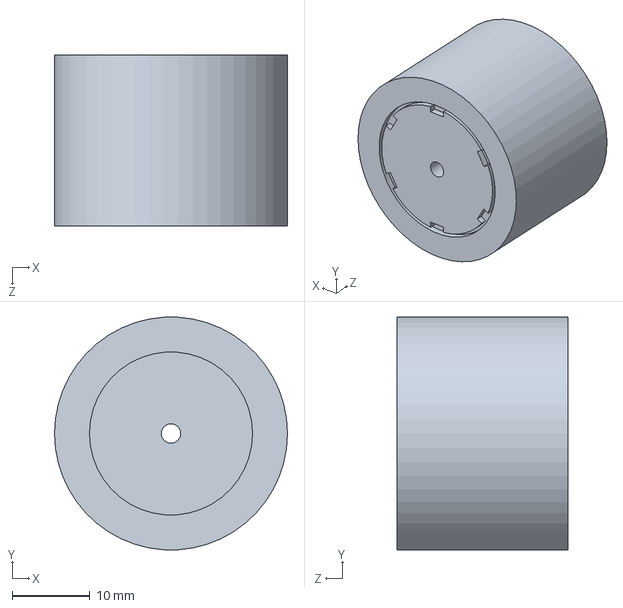
[picture p35: CAD file, 2026-10-28]
docs/cinematica/CAD/llanta.SLDPRT
30.0 x 29.9 x 22.0 mm
