juanscastano-maker/Carro_trepador/docs/cinematica/CAD/Gemfan Hurricane 3016 Propeller 3 Inch Prop w_ 1.5mm Center Hole for FPV Racing Toothpick Drone Quadcopter.step

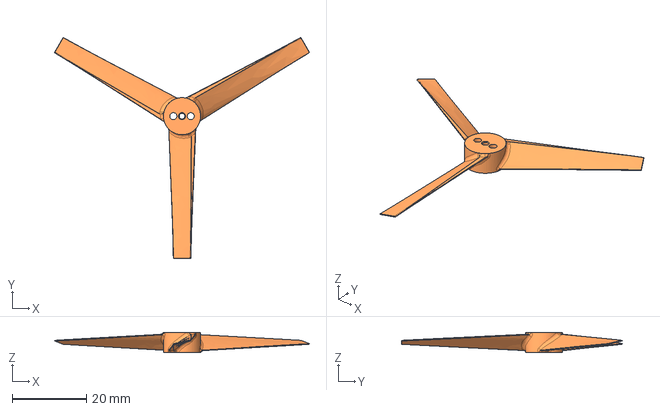
[picture p36: CAD file, 2026-10-28]
docs/cinematica/CAD/Gemfan Hurricane 3016 Propeller 3 Inch Prop w_ 1.5mm Center Hole for FPV Racing Toothpick Drone Quadcopter.step
68.7 x 59.5 x 5.50 mm
