juanscastano-maker/Carro_trepador/docs/cinematica/CAD/GNB 1100 4s 60c HV LR 88g.step

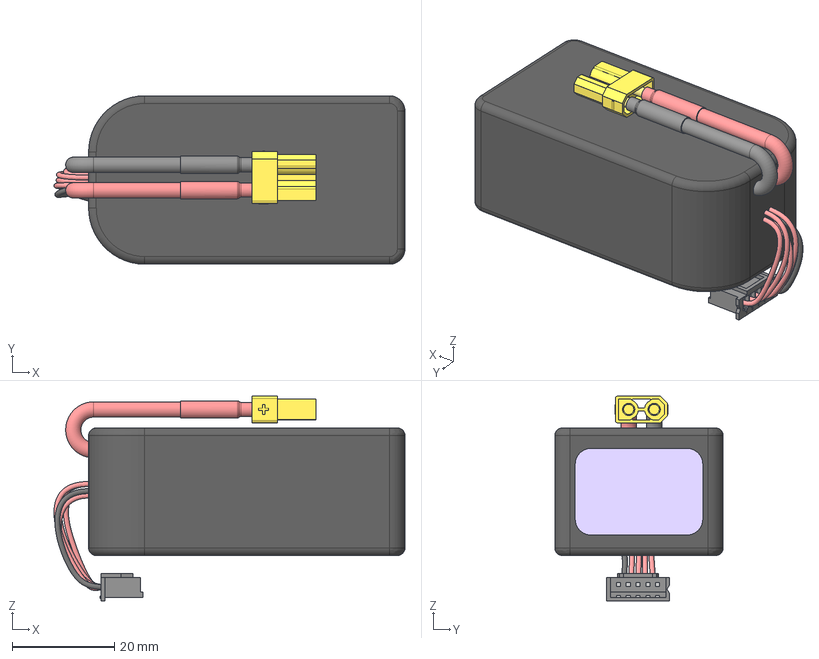
[picture p37: CAD file, 2026-10-28]
docs/cinematica/CAD/GNB 1100 4s 60c HV LR 88g.step
68.8 x 33.0 x 40.1 mm
16GA (XT30) v1 (1)
Heat Shrink (1)
16GA (XT30)
4s_Balance Lead v1
