juanscastano-maker/Carro_trepador/docs/cinematica/CAD/N20 Mini Micro Metall Gear Motor DC 3-6-12V v1.step

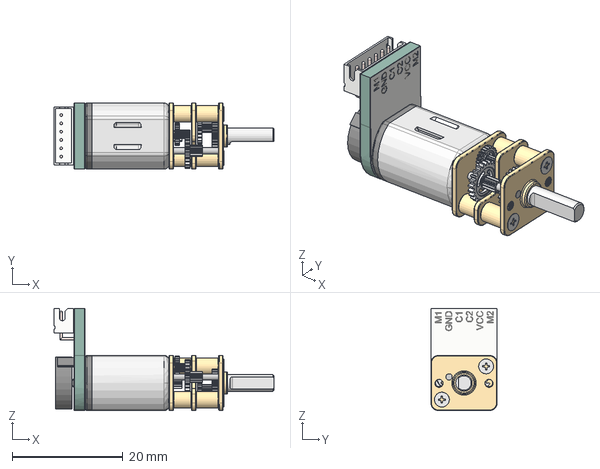
[picture p38: CAD file, 2026-10-28]
docs/cinematica/CAD/N20 Mini Micro Metall Gear Motor DC 3-6-12V v1.step
39.8 x 12.0 x 18.5 mm
