juanscastano-maker/Carro_trepador/docs/cinematica/CAD/CHASIS1.SLDPRT

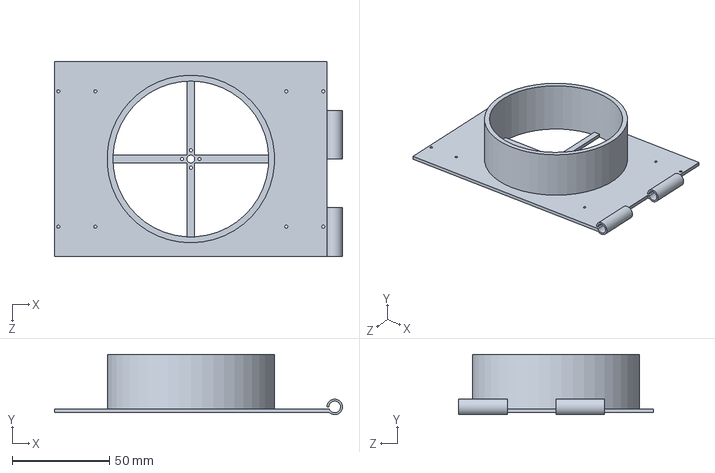
[picture p39: CAD file, 2026-10-28]
docs/cinematica/CAD/CHASIS1.SLDPRT
147.9 x 31.0 x 100.0 mm
