juanscastano-maker/Carro_trepador/docs/cinematica/CAD/Ensamblaje1_juan.SLDASM

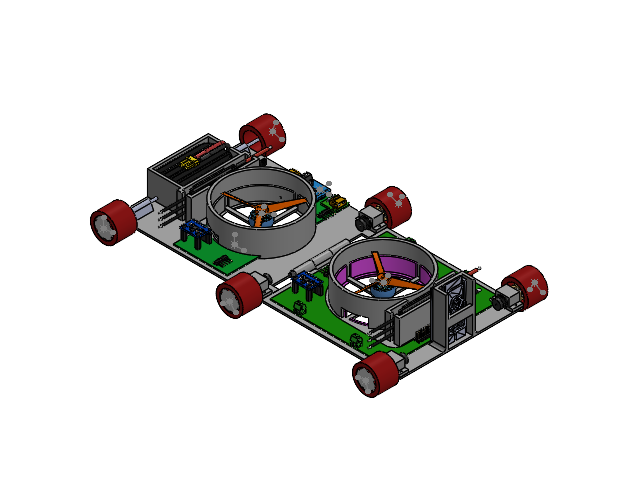
[picture p40: CAD file, 2026-10-28]
docs/cinematica/CAD/Ensamblaje1_juan.SLDASM
CHASIS1_modificado
16GA (XT30) v1 (1)_1.step
Heat Shrink (1)_1.step
16GA (XT30)_1.step
XT30 Wire-0_1.step
4s_Balance Lead v1_1.step
eBom-FreeParts_1.step
Board_001.step x 2
SOT25_001.step x 2
0603 Capacitor_001.step x 2
0603 Capacitor_002.step x 2
0603 Capacitor_003.step x 2
0603 Capacitor_004.step x 2
0603 Capacitor_005.step x 2
0603 Capacitor_006.step x 2
0603 Resistor_001.step x 2
0603 Resistor_002.step x 2
0603 Resistor_003.step x 2
0603 Resistor_004.step x 2
SM LED_001.step x 2
Diode 2_001.step x 2
24 QFN_001.step x 2
1x8 Male Header_001.step x 2
8 Pos Socket Header_001.step x 2
M2 x 11 Nylon Standoff_001.step x 2
M2 x 11 Nylon Standoff_002.step x 2
M2 Nylon Flat Washer_001.step x 2
M2 Nylon Flat Washer_002.step x 2
M2 x 5 Nylon Screw_001.step x 2
M2 x 5 Nylon Screw_002.step x 2
M2 x 5 Nylon Screw_003.step x 2
M2 x 5 Nylon Screw_004.step x 2
SOPORTE_MT x 4
Pieza7
llanta x 6
N20 Mini Micro Metall Gear Motor DC 3-6-12V v1 x 4
Pieza8
Pieza9
Pieza8^Ensamblaje1_juan
falda
Motor Bell.step x 2
Steel Insert.step x 2
Magnets.step x 2
Shaft.step x 2
2x3mm Oring.step x 2
Brass Washer.step x 4
98543A070_Side-Mount External Retaining Rings.step x 2
7487N14_Precision Stainless Steel Ball Bearing.step x 4
Motor Mount.step x 2
Stator.step x 2
Heat Shrink.step x 2
Wires-0.step x 2
Wires-1.step x 2
Wires-2.step x 2
Wires-3.step x 2
Wires-4.step x 2
Wires-5.step x 2
Wires-6.step x 2
Wires-7.step x 2
Wires-8.step x 2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
