juanscastano-maker/Carro_trepador/docs/cinematica/CAD/XT30PW-M.SLDASM

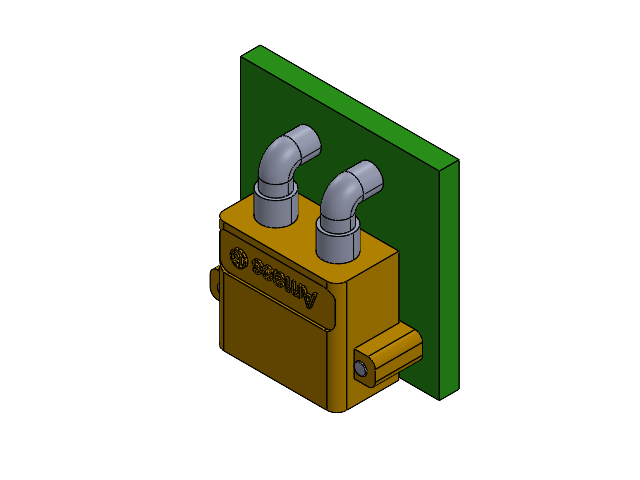
[picture p41: CAD file, 2026-10-28]
docs/cinematica/CAD/XT30PW-M.SLDASM
XT30PW-M_base.step
Pin_M_001.step x 2
fixture_003.step x 2
PCB_for_XT30PW-M.step
