juanscastano-maker/Carro_trepador/docs/cinematica/CAD/MPU6050 With Mounting Hardware.SLDASM

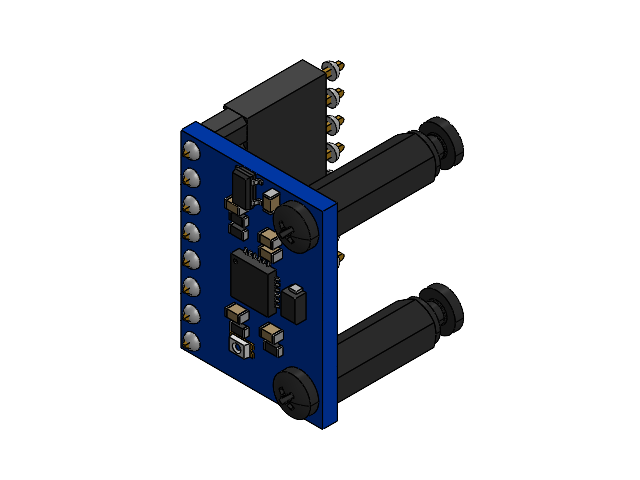
[picture p42: CAD file, 2026-10-28]
docs/cinematica/CAD/MPU6050 With Mounting Hardware.SLDASM
Board_001.step
SOT25_001.step
0603 Capacitor_001.step
0603 Capacitor_002.step
0603 Capacitor_003.step
0603 Capacitor_004.step
0603 Capacitor_005.step
0603 Capacitor_006.step
0603 Resistor_001.step
0603 Resistor_002.step
0603 Resistor_003.step
0603 Resistor_004.step
SM LED_001.step
Diode 2_001.step
24 QFN_001.step
1x8 Male Header_001.step
8 Pos Socket Header_001.step
M2 x 11 Nylon Standoff_001.step
M2 x 11 Nylon Standoff_002.step
M2 Nylon Flat Washer_001.step
M2 Nylon Flat Washer_002.step
M2 x 5 Nylon Screw_001.step
M2 x 5 Nylon Screw_002.step
M2 x 5 Nylon Screw_003.step
M2 x 5 Nylon Screw_004.step
