juanscastano-maker/Carro_trepador/(list of files, cad)

Other CAD files:
docs/cinematica/CAD/varilla para eje carrito ensamble.SLDPRT
docs/cinematica/CAD/Folder 03_1.step.SLDASM
docs/cinematica/CAD/Gemfan Hurricane 3016 Propeller 3 Inch Prop w_ 1.5mm Center Hole for FPV Racing Toothpick Drone Quadcopter_2.step.SLDASM
docs/cinematica/CAD/URDF/Ensamblaje1_juan/meshes/rueda_trasera_derecha_link.STL
docs/cinematica/CAD/archivos stl binario para impresion 3d/falda frontal.STL
docs/cinematica/CAD/Folder 03-0_1.step.SLDPRT
docs/cinematica/CAD/archivos stl binario para impresion 3d/SOPORTE_MT.STL
docs/cinematica/CAD/URDF/Ensamblaje1_juan/meshes/rueda_media_derecha_link.STL
ros2_ws/src/carro_trepador_description/meshes/rueda_media_izquierda_Link.STL
ros2_ws/src/carro_trepador_description/meshes/rueda_delantera_derecha_Link.STL
docs/cinematica/CAD/Pieza8.SLDPRT
docs/cinematica/CAD/Pieza9.SLDPRT
docs/cinematica/CAD/CHASIS1_modificado.SLDPRT
docs/cinematica/CAD/Pieza7.SLDPRT
docs/cinematica/CAD/falda frontal.SLDPRT
docs/cinematica/CAD/CHASIS2_modificado.SLDPRT
docs/cinematica/CAD/falda.SLDPRT
docs/cinematica/CAD/GNB 1100 4s 60c HV LR 88g.SLDASM
docs/cinematica/CAD/N20 Mini Micro Metall Gear Motor DC 3-6-12V v1.SLDPRT
docs/cinematica/CAD/XING2 1404 v5.f3d
