juanscastano-maker/Carro_trepador/(commit log)

2026-09-04 Agrega .gitignore y workspace de VS Code para ROS 2 en la raíz del repositorio
2026-09-05 cambiamos el readme, ya con la estructura mejorada para el repositorio y el proyecto
    Updated README structure and added detailed sections for ROS 2, hardware, firmware, MATLAB, scripts, tests, and documentation.
2026-09-05 Creacion de carpetas en
2026-09-05 Agregue los archivos .gitkeep para poder subir las carpetas
2026-09-05 Agrega estructura base de paquetes en ros2_ws
2026-09-06 Edite el bringup.launch.py que estaba vacio
2026-09-10 lista de materiales, anteproyecto y arquitectura
    estan prestes a cambios
2026-10-04 Arquitectura v3: grafo de nodos actualizado y documento corregido
    - Agrega docs/arquitectura/Arquitectura_Carro_trepador_v3.docx con tablas de
    nodos, tópicos, servicios, seguridad (e-stop, watchdog, rearme) y pendientes
    - Agrega el grafo de nodos (grafo nodos microproyecto.drawio.png)
    - Elimina el PDF de arquitectura anterior y el .gitkeep de docs/arquitectura
    - Actualiza la lista de materiales
